evgkg/shapdesk-esphome/hardware/enclosure/shapdesk_enclosure.step

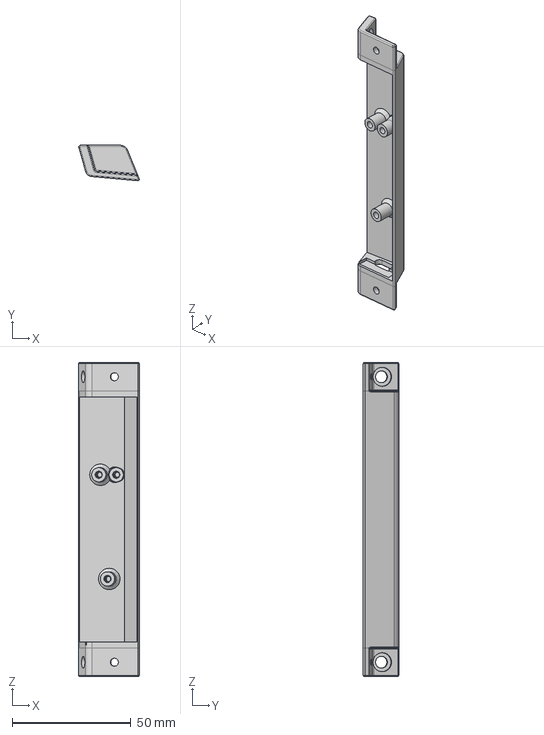
[picture p9: CAD file, 2026-10-28]
hardware/enclosure/shapdesk_enclosure.step
25.5 x 14.9 x 132.0 mm
