evgkg/shapdesk-esphome/hardware/enclosure/shapdesk_connector_retainer.step

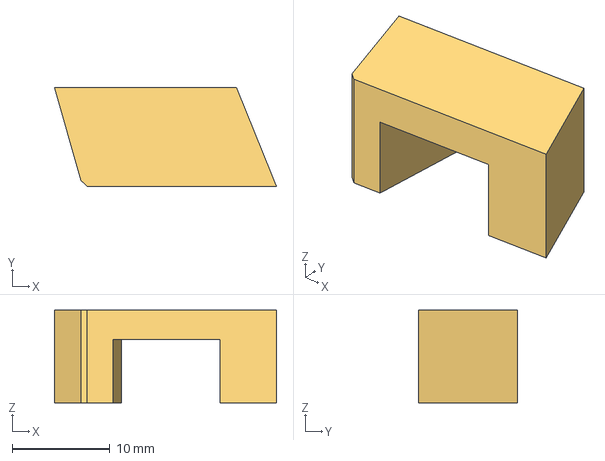
[picture p10: CAD file, 2026-10-28]
hardware/enclosure/shapdesk_connector_retainer.step
22.7 x 10.1 x 9.50 mm
