evgkg/shapdesk-esphome/(list of files, cad)

Other CAD files:
hardware/enclosure/shapdesk_connector_retainer.stl
hardware/enclosure/shapdesk_enclosure.stl
