evgkg/shapdesk-esphome/docs/assembly.ru.md

# Инструкция по сборке

[English](assembly.md) · **Русский** · [Назад к README](../README.ru.md)

Инструкция для платы **rev2** из `hardware/pcb/`. Список деталей: [`hardware/bom.csv`](../hardware/bom.csv).

Понадобятся: паяльник с тонким жалом, флюс, пинцет, мультиметр, насадка для вплавления втулок (можно обойтись обычным жалом), обжимка для контактов Dupont и дрель.

## 1. Печать деталей

Напечатайте `hardware/enclosure/shapdesk_enclosure.stl` и `shapdesk_connector_retainer.stl`. Подойдёт любой FDM-пластик, в который можно вплавлять втулки (PLA, PETG и т. п.).

Вплавьте три втулки **M2 × 2.5 × 3.2** в стойки для платы внутри корпуса.

## 2. Пайка платы

Вся мелочь стоит на **нижней** стороне. Там же на шелкографии подписаны номера деталей, номиналы (`R1-R7 100k  R8-R14 4.7k  R15 10k  R16 18k  C1 C2 10uF`) и какая кнопка за каким транзистором (`K1 UP` … `K7 M`).

1. Сначала запаяйте питание: U2 (ME6211, SOT-23-5), C1 и C2.
2. Резисторы R1–R16. 100 кОм и 4.7 кОм легко перепутать, держите их в разных кучках.
3. Транзисторы Q1–Q7 (MMBT3904).
4. Прозвоните мультиметром, что 5 В, 3.3 В и GND не замкнуты между собой.
5. **Верхняя сторона:** ESP32-C3 SuperMini на штырьках из комплекта (USB-C смотрит в сторону, противоположную J1) и угловой разъём J1 (загнутые штыри смотрят к краю платы, как нарисовано на шелкографии).

## 3. Прошивка

Прошейте плату по USB, **пока она не подключена к пульту**. Проверьте, что в `shapdesk.yaml` стоит `board_revision: "2"` (это значение по умолчанию), и дальше делайте всё по разделу [Установка и прошивка](../README.ru.md#установка-и-прошивка). При загрузке в логе должна быть строка:

```
Board rev2: K1..K7 = GPIO5/3/7/0/10/1/4, UART RX = GPIO6
```

## 4. Подготовка пульта

Разберите пульт. Провода выходят из пульта через отверстие в задней крышке, потом его закроет корпус модуля. Вплавьте в заднюю крышку две втулки **M3 × 4 × 4** напротив отверстий во фланце корпуса — чтобы разметить, просто приложите корпус к крышке.

| Крышка с отверстием и втулками, плата в корпусе | Провода выходят через заднюю крышку |
|---|---|
|  |  |

## 5. Провода к плате пульта

Проводов девять: три идут на площадки GND, RX и 5 В у края платы, остальные шесть — на T3, T4 и T5, по два на каждую деталь. Какие именно ноги, показано на фото. Третью ногу этих деталей не трогайте.

Куда паять

Как устроена матрица кнопок:

Матрица кнопок

Советы:

- Сначала залудите ноги, потом приложите залуженный провод и коротко коснитесь паяльником.
- Прихватите провода к плате термоклеем или скотчем, чтобы они не тянули за маленькие ноги SOT-23.
- На RX сигнал 5 В, но делитель уже стоит на плате модуля, так что провод идёт прямо на J1-2.

## 6. Кабель

Обожмите контакты Dupont и вставьте их в колодку 2×5 по номерам J1:

| J1 | Провод | | J1 | Провод |
|---:|---|---|---:|---|
| 1 | GND | | 2 | RX |
| 3 | T3H | | 4 | T3L |
| 5 | T4H | | 6 | T4L |
| 7 | T5H | | 8 | T5L |
| 9 | 5V | | 10 | не используется |

Те же подписи есть на нижней стороне платы рядом с J1.

Перед тем как подключать, прозвоните каждое гнездо колодки до его точки на плате пульта и проверьте, что соседние гнёзда не замкнуты.

## 7. Сборка в корпус

1. Наденьте колодку на J1 и вставьте фиксатор между колодкой и стенкой корпуса.
2. Прикрутите плату к корпусу тремя винтами M2 × 8 с полукруглой головкой.
3. Соберите пульт и прикрутите к нему корпус двумя винтами M3 × 6 с полукруглой головкой.

## 8. Проверка

Добавьте модуль в Home Assistant и пройдите [первую проверку на столе](../README.ru.md#первая-проверка-на-столе). Начинайте с коротких нажатий, пульт держите под рукой.

## Если что-то не работает

- **Высоты нет, «Связь с пультом» выключена:** проверьте `board_revision` и провода RX и GND. На плате, отключённой от пульта, между J1-2 и J1-1 должно быть около 28 кОм (это делитель 10k + 18k).
- **Не работает одна или несколько кнопок:** одни и те же провода идут сразу к нескольким кнопкам, поэтому ищите общий провод. Например, не работают ▼ и 2 — проверьте T3H, не работают 1 и 2 — T5H. Перепаяйте этот провод и проверьте, хорошо ли обжат его контакт.
- **Стол едет вниз во время прошивки:** это проблема платы rev1, см. [README](../README.ru.md#известная-проблема-rev1-стол-едет-вниз-во-время-прошивки).
