evgkg/shapdesk-esphome/hardware/pcb/shapdesk_rev2_schematic.pdf

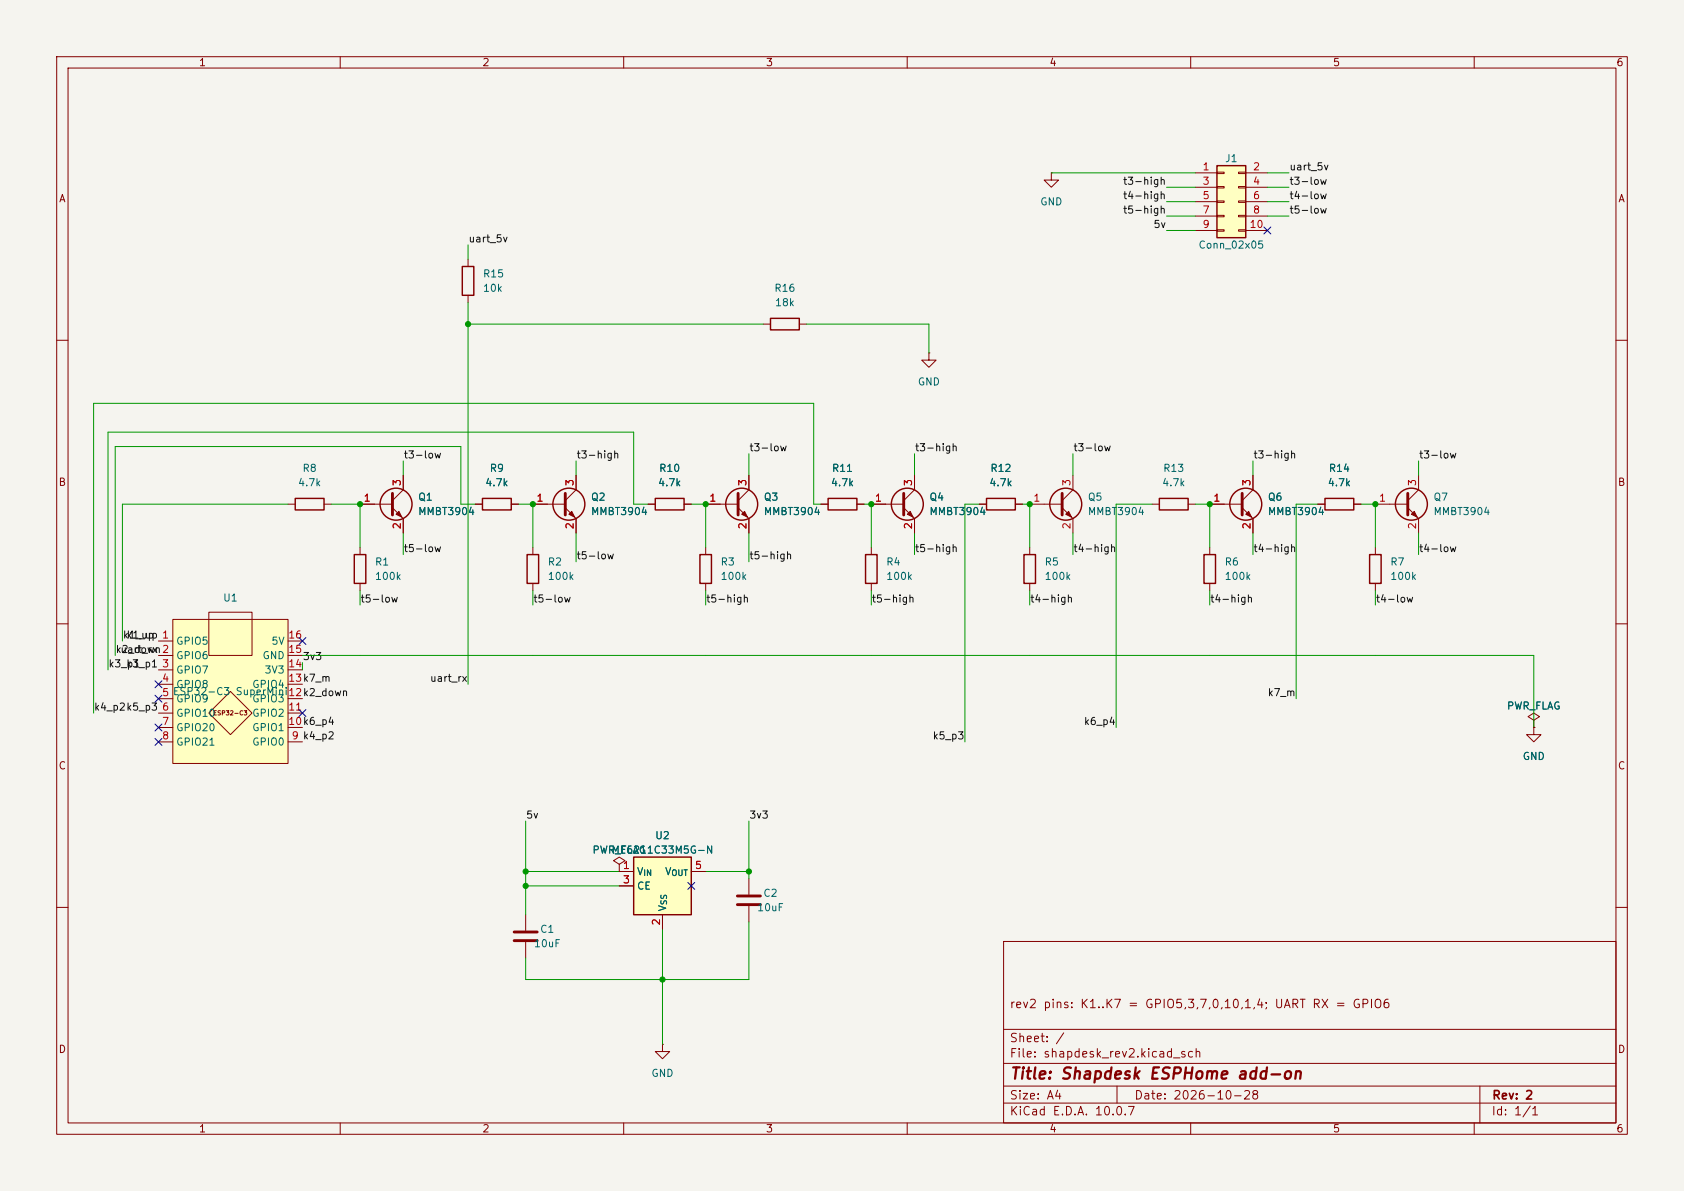
[picture p13: page 1]

Sheet: /
File: shapdesk_rev2.kicad_sch
Title: Shapdesk ESPHome add-on

Size: A4 | Rev: 2
KiCad E.D.A. 10.0.7 | Id: 1/1
