evgkg/shapdesk-esphome/hardware/pcb/shapdesk_rev2.kicad_pcb

## KiCad design hardware/pcb/shapdesk_rev2.kicad_pcb (2026-10-28)

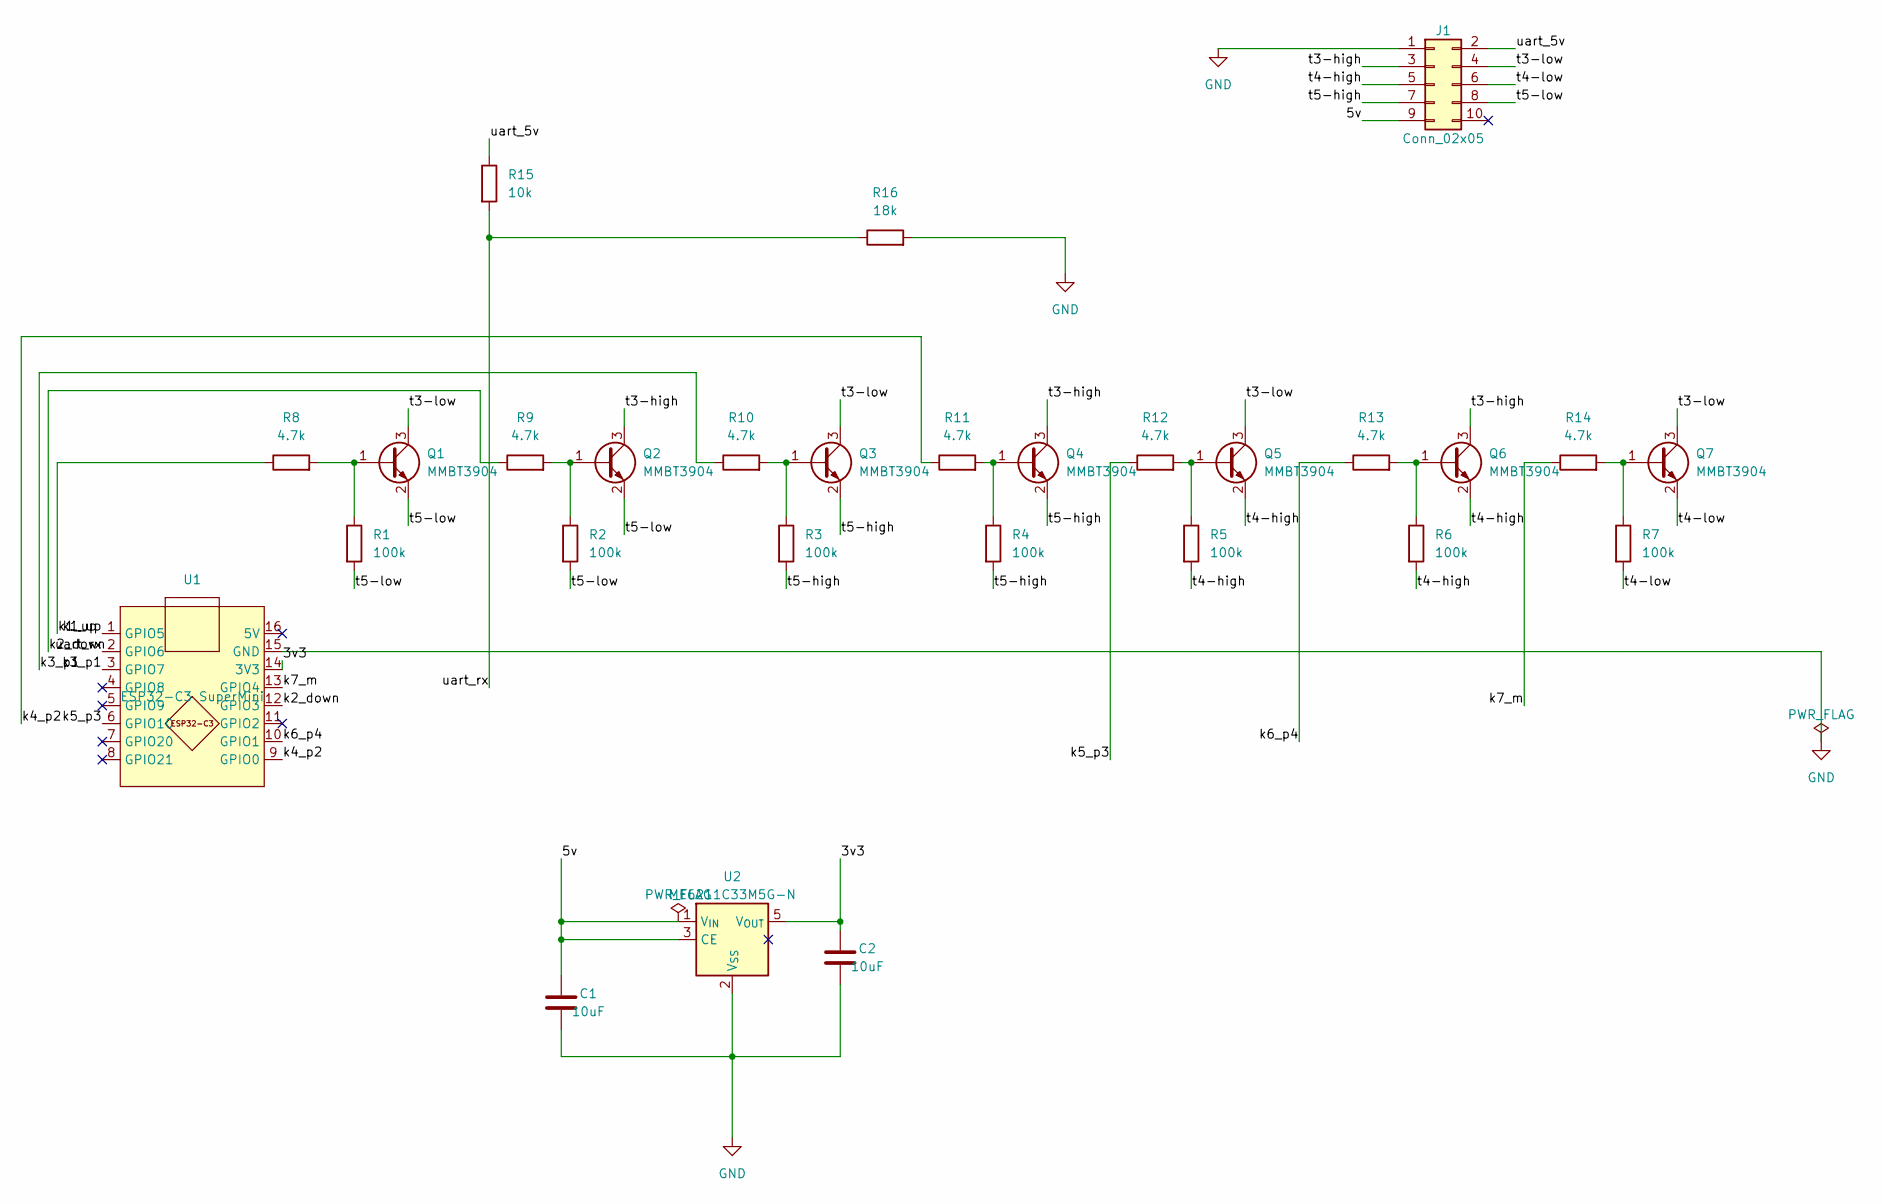
[picture p14: schematic shapdesk_rev2.kicad_sch, Shapdesk ESPHome add-on]

Parts:
C1, C2: 10uF; C_0805_2012Metric
J1: Conn_02x05; PinHeader_2x05_P2.54mm_Horizontal
Q1, Q2, Q3, Q4, Q5, Q6, Q7: MMBT3904; SOT-23_Handsoldering
R1, R2, R3, R4, R5, R6, R7: 100k; R_0603_1608Metric
R8, R9, R10, R11, R12, R13, R14: 4.7k; R_0603_1608Metric
R15: 10k; R_0603_1608Metric
R16: 18k; R_0603_1608Metric
U1: ESP32-C3 SuperMini; ESP32-C3_SuperMini_2x08
U2: ME6211C33M5G-N; SOT-23-5

Connections:
/3v3: C2.1, U1.14 (3V3), U2.5 (V_{OUT})
/5v: C1.1, J1.9, U2.1 (V_{IN}), U2.3 (CE)
/k1_up: R8.1, U1.1 (GPIO5)
/k2_down: R9.1, U1.12 (GPIO3)
/k3_p1: R10.1, U1.3 (GPIO7)
/k4_p2: R11.1, U1.9 (GPIO0)
/k5_p3: R12.1, U1.6 (GPIO10)
/k6_p4: R13.1, U1.10 (GPIO1)
/k7_m: R14.1, U1.13 (GPIO4)
/t3-high: J1.3, Q2.3 (C), Q4.3 (C), Q6.3 (C)
/t3-low: J1.4, Q1.3 (C), Q3.3 (C), Q5.3 (C), Q7.3 (C)
/t4-high: J1.5, Q5.2 (B), Q6.2 (B), R5.2, R6.2
/t4-low: J1.6, Q7.2 (B), R7.2
/t5-high: J1.7, Q3.2 (B), Q4.2 (B), R3.2, R4.2
/t5-low: J1.8, Q1.2 (B), Q2.2 (B), R1.2, R2.2
/uart_5v: J1.2, R15.1
/uart_rx: R15.2, R16.1, U1.2 (GPIO6)
GND: C1.2, C2.2, J1.1, R16.2, U1.15 (GND), U2.2 (V_{SS})
unnamed: Q1.1 (E), R1.1, R8.2
unnamed: Q2.1 (E), R2.1, R9.2
unnamed: Q3.1 (E), R3.1, R10.2
unnamed: Q4.1 (E), R4.1, R11.2
unnamed: Q5.1 (E), R5.1, R12.2
unnamed: Q6.1 (E), R6.1, R13.2
unnamed: Q7.1 (E), R7.1, R14.2

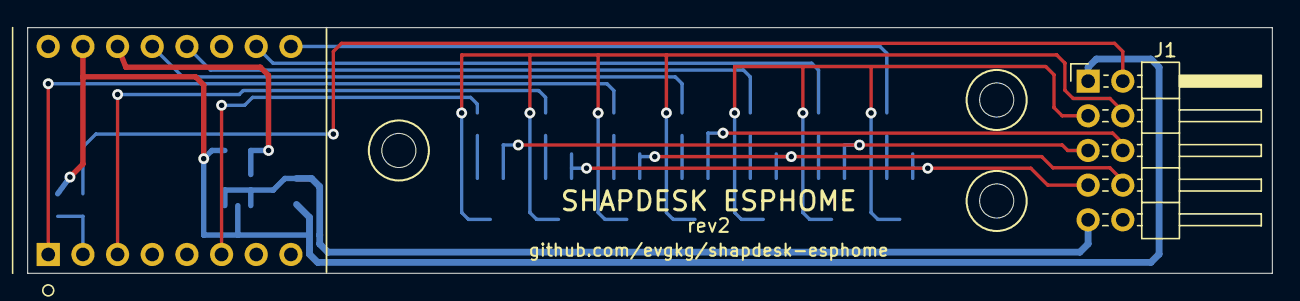
[picture p15: board shapdesk_rev2.kicad_pcb from above]

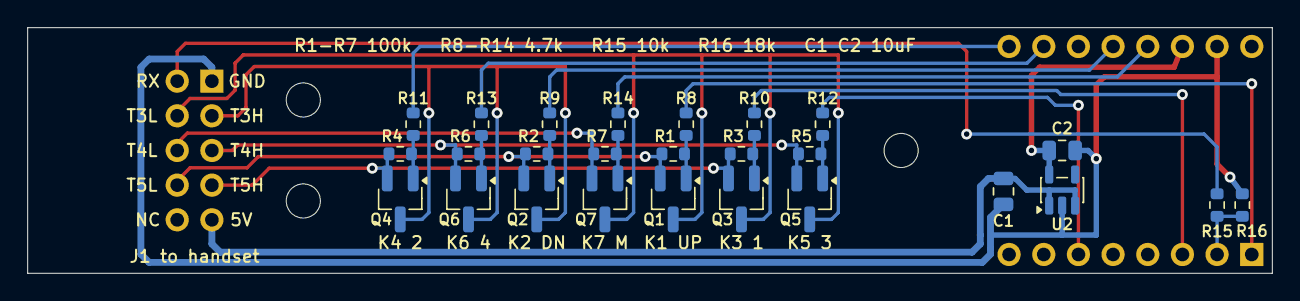
[picture p16: board shapdesk_rev2.kicad_pcb from below]

Board: 2 copper layers, 91.2 x 18.0 mm, 31 parts (26 on the bottom side), 25 nets.

Other parts of the board:
H1, H2, H3: M2; MountingHole_2.5mm_M2
